wassware/Arduino-18650-battery-tester/documentation/with fan.jpg

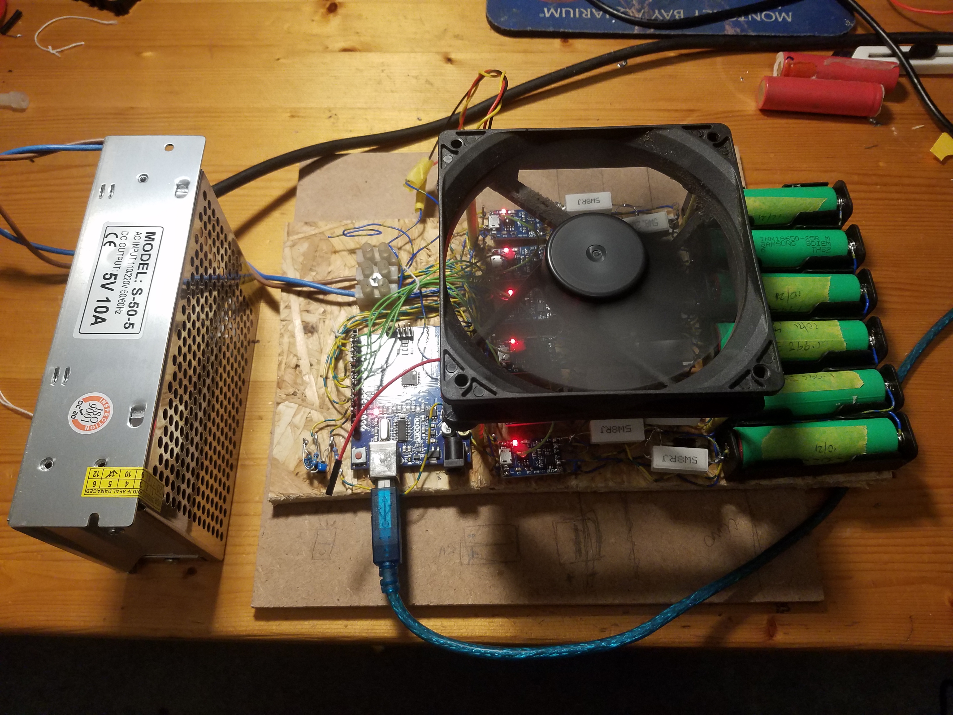
documentation/with fan.jpg
