wassware/Arduino-18650-battery-tester/documentation/4056 module.jpg

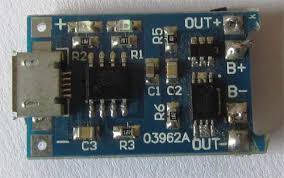
documentation/4056 module.jpg
