wassware/Arduino-18650-battery-tester/documentation/4056 diagram.png

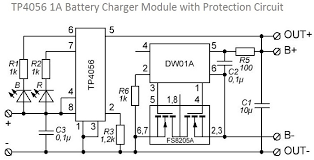
documentation/4056 diagram.png
