wassware/Arduino-18650-battery-tester/documentation/Wiring.pdf

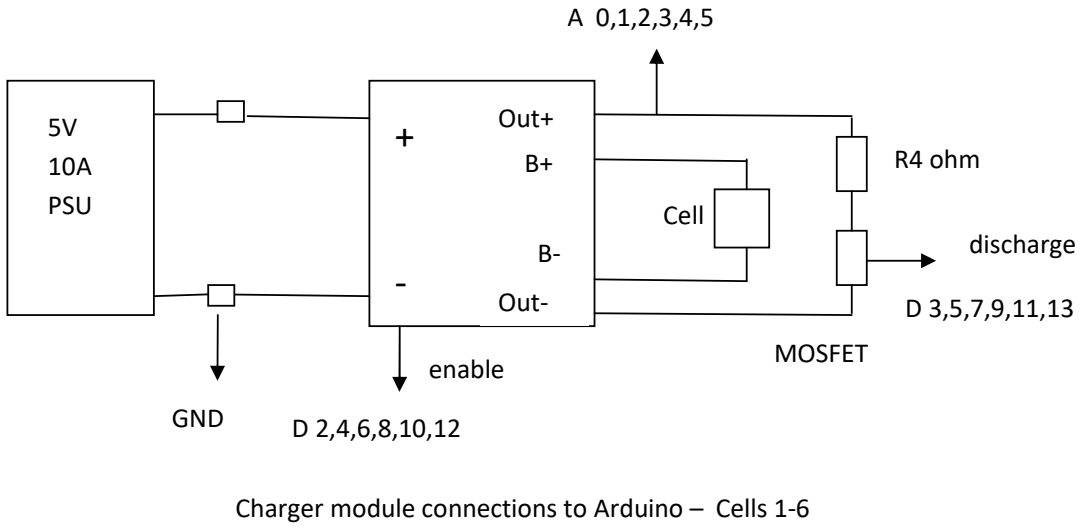
[picture p4: figure]
Cell; R4 ohm; MOSFET enable; Out-; Out+; GND; discharge; 5V 10A PSU

Charger module connections to Arduino – Cells 1-6

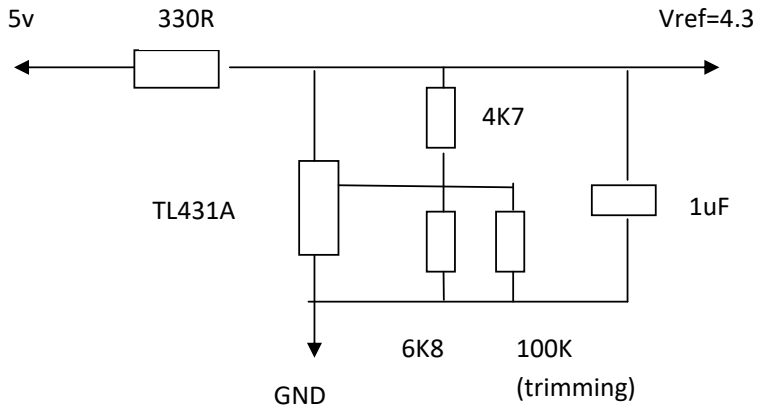
[picture p5: figure]
GND; (trimming); Vref=4.3

Analog VREF supply
